danupp/rotor_control/rotor_control_kicad/rotor_control_kicad.pdf

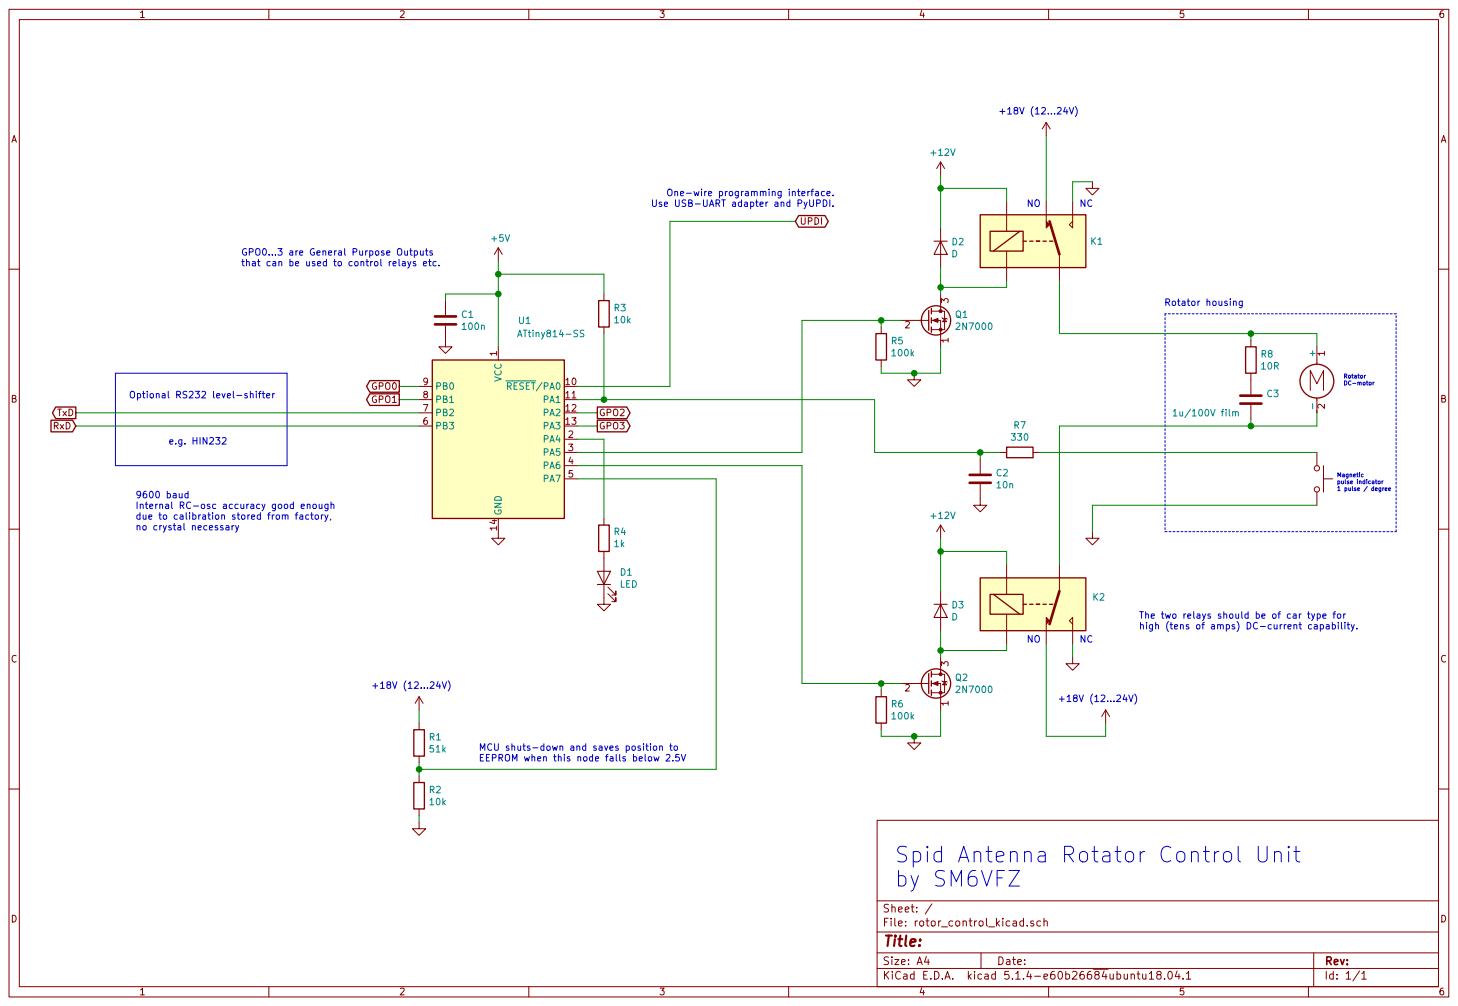
[picture p1: page 1]

One-wire programming interface.

GPO0...3 are General Purpose Outputs
that can be used to control relays etc.

Magnetic pulse indicator 1 pulse / degree Spid Antenna Rotator Control Unit

9600 baud
Internal RC-osc accuracy good enough
due to calibration stored from factory,
no crystal necessary

The two relays should be of car type for
high (tens of amps) DC-current capability.

MCU shuts-down and saves position to EEPROM when this node falls below 2.5V
