danupp/rotor_control/main.c

/* Rotor control for Spid rotors by SM6VFZ

Commands:
r x     --- Rotate to direction/position x degrees
r+ x    --- Rotate clock-wise for x degrees
r- x    --- Rotate counter-clock-wise for x degrees
d       --- Print current position
s       --- Stop ongoing rotation
cal x   --- Set current position to x degrees (without rotating) 
g on y  --- Turn on output y in {0,1,2,3}
g off y --- Turn off output y
temp    --- Measure and print current temperature
 
*/

#include <avr/io.h>
#include <avr/interrupt.h>
#include <avr/pgmspace.h>
#include <avr/sleep.h>
#include <avr/eeprom.h>
#define F_CPU 3333333
#include <util/delay.h>
#include <stdio.h>
#include <stdlib.h>
#include <string.h>

#define LED_pin PIN4_bm // PA4
#define TXD_pin PIN2_bm // PB2
#define RXD_pin PIN3_bm // PB3
#define COMP_pin PIN7_bm // PA7
#define PULSE_pin PIN1_bm // PA1
#define RELA_pin PIN5_bm // PA5
#define RELB_pin PIN6_bm // PA6
#define GPO0_pin PIN0_bm //PB0
#define GPO1_pin PIN1_bm //PB1
#define GPO2_pin PIN2_bm //PA2
#define GPO3_pin PIN3_bm //PA3

#define CW 0x01
#define CCW 0x02
#define MAX_POS 450
#define MIN_POS -90

#define POSITION_EEADDR 0

volatile uint8_t step_flag;
volatile uint8_t process_usart_flag;
volatile uint8_t timeout_flag;
volatile uint8_t rot_flag;
volatile uint8_t poweroff_flag;
volatile uint8_t rx_ptr;
volatile uint8_t timeout;
volatile char rx_buff[30];

uint8_t gpo_on(uint8_t gpo_num) {
  if (gpo_num == 0)
    PORTB.OUT |= GPO0_pin;
  else if (gpo_num == 1)
    PORTB.OUT |= GPO1_pin;
  else if (gpo_num == 2)
    PORTA.OUT |= GPO2_pin;
  else if (gpo_num == 3)
    PORTA.OUT |= GPO3_pin;
  else
    return 1;
  return 0;
}

uint8_t gpo_off(uint8_t gpo_num) {
  if (gpo_num == 0)
    PORTB.OUT &= ~GPO0_pin;
  else if (gpo_num == 1)
    PORTB.OUT &= ~GPO1_pin;
  else if (gpo_num == 2)
    PORTA.OUT &= ~GPO2_pin;
  else if (gpo_num == 3)
    PORTA.OUT &= ~GPO3_pin;
  else
    return 1;
  return 0;
}

void RotStop() {
  rot_flag = 0x00;
  PORTA.OUT &= ~RELA_pin;
  PORTA.OUT &= ~RELB_pin;
  PORTA.OUT &= ~LED_pin;
}

void RotStart(uint8_t dir) {
  rot_flag = 0x01;
  timeout = 0;
  if (dir == CW) {
    PORTA.OUT |= RELA_pin;
    PORTA.OUT &= ~RELB_pin;
  }
  else if (dir == CCW) {
    PORTA.OUT |= RELB_pin;
    PORTA.OUT &= ~RELA_pin;
  }    
  PORTA.OUT |= LED_pin;
}


void USART_Transmit_String(char *buffer) {
  uint8_t n = 0;
  while(buffer[n]) {
    while (!(USART0.STATUS & USART_DREIF_bm));
    USART0.TXDATAL = buffer[n];
    n++;
  }
}

uint16_t measure_temperature() {
  int8_t sigrow_offset = SIGROW.TEMPSENSE1;
  uint8_t sigrow_gain = SIGROW.TEMPSENSE0;
  uint32_t temp;
  //ADC0.MUXPOS = 0x1e; // tempsense
  //_delay_ms(1);
  ADC0.COMMAND = 0x01;
  while (ADC0.COMMAND);
  // Now convert as per datasheet
  temp = ADC0.RES - sigrow_offset;
  temp *= sigrow_gain;
  temp += 0x80;
  temp >>= 8;
  return temp;
}

ISR(AC0_AC_vect) {

  RotStop(); // just in case
  AC0.STATUS |= 0x01; // Clear int flag
  if (!(AC0.STATUS & 0b00010000)) 
    poweroff_flag = 0x01;
    
}

ISR(BOD_VLM_vect) {

  RotStop(); // just in case
  poweroff_flag = 0x02;
}


ISR(RTC_PIT_vect) { // 2 Hz
  RTC.PITINTFLAGS = 0x01; // clear flag
  //PORTA.OUTTGL = LED_pin;
  if (rot_flag) {
    timeout ++;
    if(timeout>4) {
      RotStop();
      timeout_flag = 0x01;
    }
  }

}


ISR(PORTA_PORT_vect) {
  
  if(PORTA.INTFLAGS & PULSE_pin) {
    PORTA.INTFLAGS |= PULSE_pin; // Clear flag
    step_flag = 0x01;
  }  
}

/*
ISR(TCA0_OVF_vect) { // 192.0 kHz @ 19.2 MHz 
  TCA0.SINGLE.INTFLAGS = 0x01; // clear flag
}
*/

ISR (USART0_RXC_vect) {

  unsigned char udr_rx;

  /* Get and return received data from buffer */
  if (USART0.RXDATAH & USART_FERR_bm)
    udr_rx = USART0.RXDATAL;
  else {
    udr_rx = USART0.RXDATAL;
    USART0.TXDATAL = udr_rx;
    
    if (udr_rx=='\n') {
      process_usart_flag = 1;
    }
    else if (rx_ptr < 28) {
      rx_buff[rx_ptr]=udr_rx;
      rx_ptr++;
    }
  }
}

void main () {
  char buffer[50];
  int16_t position, target_position, ang;
  uint8_t direction;

  static const char string_start[] PROGMEM = "\n*******\nRotor control by SM6VFZ\n\n";
  static const char string_timeout[] PROGMEM = "\nTimeout, No feedback!\n";
  static const char string_temperature[] PROGMEM = "Temperature: ";
  static const char string_step_too_small[] PROGMEM = "Step too small.";
  static const char string_pos[] PROGMEM = "Position: ";
  static const char string_forcing[] PROGMEM = "-> Forcing pos to ";
  static const char string_degrees[] PROGMEM = " deg";
  static const char string_stopping[] PROGMEM = "Stopping at ";
  static const char string_starting[] PROGMEM = "Starting rot..";
  // static const char string_save[] PROGMEM = "Saving position to EEPROM.";
  // static const char string_load[] PROGMEM = "(Re)loading position from EEPROM.";
  static const char string_gpo_on[] PROGMEM = "Turning on output ";
  static const char string_gpo_off[] PROGMEM = "Turning off output ";
  static const char string_quit_ac[] PROGMEM = "\n*AC*";
  static const char string_quit_vlm[] PROGMEM = "\n*VLM*";
  static const char string_quit[] PROGMEM = "\n*** Good night. ***";
  
  PORTA.DIR = LED_pin | RELA_pin | RELB_pin | GPO2_pin | GPO3_pin; // outputs
  PORTB.DIR = TXD_pin | GPO0_pin | GPO1_pin;
  PORTA.PIN7CTRL = 0x04; // digital input disable for AINP0/PA7
  PORTA.PIN1CTRL = 0x01; // int at both edges

  PORTA.OUT = 0x00;
  PORTB.OUT = 0x00;

  _delay_ms(1000); // To wait for voltages to stabilize
  
  BOD.VLMCTRLA = 0x02; // VLM 25% over BOD
  BOD.INTCTRL = 0x01;  // VLM INT when voltage crosses from above
  
  VREF.CTRLA = 0b00010010; // 1.1V for ADC, 2.5V for comparator
  
  ADC0.CTRLC = 0x01; // int ref, ./4 prescaler
  ADC0.CTRLD = 0b10000000; // 128 CLK_ADC INITDLY
  ADC0.SAMPCTRL = 0b00001000; // 32 1/f samplen -> 38.4us
  ADC0.MUXPOS = 0x1e; // tempsense
  ADC0.CTRLA = 0b00000001; // ADC enable at 10 bits resolution

  measure_temperature();  // Seems necessary to get rid of first garbage values

  AC0.MUXCTRLA = 0x02; // VREF to NEGIN
  AC0.INTCTRL = 0x01; // enable interrupt
  AC0.CTRLA = 0b00100001; // int at neg edge, no hyst, enable

  //USART0.BAUD = 1389;  // 9600 baud for 3.33 MHz and normal mode

  /* Baud rate compensated with factory stored frequency error */
  int8_t sigrow_val = SIGROW.OSC20ERR5V;
  int32_t baud_reg_val = (int32_t)1389;

  baud_reg_val *= (1024 + sigrow_val);
  baud_reg_val /= 1024;
  USART0.BAUD = (int16_t) baud_reg_val;

  USART0.CTRLA = 0b10000000; // RXCIE
  USART0.CTRLB = 0b11000000; // RX+TX enable
  rx_ptr=0;
  
  while(RTC.STATUS);
  RTC.CLKSEL = 0x00; // Use 32 kHz from OSC32K
  while(RTC.PITSTATUS);
  RTC.PITINTCTRL = 0x01; // enable interrupt
  while(RTC.PITSTATUS);
  RTC.PITCTRLA = 0b01101001; // Enable, interrupt after 16384 cycles => 2Hz

  position = eeprom_read_word(POSITION_EEADDR); // Read out last position
  
  strcpy_P(buffer, string_start);
  USART_Transmit_String(buffer);
  sprintf(buffer,"\nStart at %d deg.\n> ", position);
  USART_Transmit_String(buffer);

  PORTA.OUT |= LED_pin;
  _delay_ms(200);
  PORTA.OUT &= ~LED_pin;
  _delay_ms(200);
  PORTA.OUT |= LED_pin;
  _delay_ms(200);
  PORTA.OUT &= ~LED_pin;
  _delay_ms(200);
  PORTA.OUT |= LED_pin;
  _delay_ms(200);
  PORTA.OUT &= ~LED_pin;

  rot_flag = 0x00;
  step_flag = 0x00;
  process_usart_flag = 0x00;
  timeout_flag = 0x00;
  poweroff_flag = 0x00;

  AC0.STATUS |= 0x01; // Clear int flag
  
  sei();
   
  while(1) {
    if(poweroff_flag) {
      cli();
      eeprom_write_word(POSITION_EEADDR,position);
      if (poweroff_flag == 0x01) { // AC 
	strcpy_P(buffer, string_quit_ac);
      }
      else if (poweroff_flag == 0x02) { // VLM
	strcpy_P(buffer, string_quit_vlm);
	BOD.INTFLAGS = 0x00;
      }
      USART_Transmit_String(buffer);
      strcpy_P(buffer, string_quit);
      USART_Transmit_String(buffer);
      _delay_ms(10000);
      poweroff_flag = 0x00;
      sei(); // if we wake up again
    }
    else if(step_flag) {
      cli();
      step_flag = 0x00;
      _delay_ms(5);
      if ((direction == CW) && (PORTA.IN & PULSE_pin)) { // Low-to-high
	timeout = 0;
	position++;
	USART_Transmit_String("+");
	if(rot_flag && ((position > MAX_POS) || (position >= target_position))) {
	  RotStop();
	  USART_Transmit_String("\n> ");
	}
      }
      else if ((direction == CCW) && !(PORTA.IN & PULSE_pin)) { //High-to-low
	timeout = 0;
	position--;
	USART_Transmit_String("-");
	timeout = 0;
	if (rot_flag && ((position < MIN_POS) || (position <= target_position))) {
	  RotStop();
	  USART_Transmit_String("\n> ");
	}
      }
      PORTA.INTFLAGS |= PULSE_pin; // Clear flag, if set again
      sei();
    }
    else if (process_usart_flag) {
      rx_ptr=0;
      
      if (strncmp((const char *)rx_buff,"?",1)==0) {
         strcpy_P(buffer, string_start);
	 USART_Transmit_String(buffer);
      }
      else if (strncmp((const char *)rx_buff,"temp",4)==0) {
         strcpy_P(buffer, string_temperature);
	 USART_Transmit_String(buffer);
	 sprintf(buffer,"%d C",measure_temperature()-273);
	 USART_Transmit_String(buffer);
      }
      else if (strncmp((const char *)rx_buff,"r+ ",3)==0) {
         if(sscanf((const char *)rx_buff+3,"%d",&ang)) {
            if (ang > 3) {
	      target_position=position+ang;
	      direction = CW;
	      RotStart(direction);
	      strcpy_P(buffer, string_starting);
	      USART_Transmit_String(buffer);
	    }
	    else {
	       strcpy_P(buffer, string_step_too_small);
	       USART_Transmit_String(buffer);
            }
	 }
      }
      else if (strncmp((const char *)rx_buff,"r- ",3)==0) {
         if(sscanf((const char *)rx_buff+3,"%d",&ang)) {
            if (ang > 3) {
	      target_position=position-ang;
	      direction=CCW;
	      RotStart(direction);
	      strcpy_P(buffer, string_starting);
	      USART_Transmit_String(buffer);
	    }
	    else {
	       strcpy_P(buffer, string_step_too_small);
	       USART_Transmit_String(buffer);
            }
	 }
      }
      else if (strncmp((const char *)rx_buff,"r ",2)==0) {
	if(sscanf((const char *)rx_buff+2,"%d",&ang)) {
	  if ((ang > (position - 3)) && (ang < (position + 3))) {
 	    strcpy_P(buffer, string_step_too_small);
	    USART_Transmit_String(buffer);
	  }
	  else {
	    if (ang > position) {
	      target_position = ang;
	      direction=CW;
	      RotStart(direction);
	    }
	    else if (ang < position) {
	      target_position = ang;
	      direction=CCW;
	      RotStart(direction);
	    }
	    strcpy_P(buffer, string_starting);
	    USART_Transmit_String(buffer);
	  }
	}
      }
      else if (strncmp((const char *)rx_buff,"cal ",4)==0) {
	if(sscanf((const char *)rx_buff+4,"%d",&ang)) {
	  position = ang;
	  strcpy_P(buffer, string_forcing);
	  USART_Transmit_String(buffer);
	  sprintf(buffer,"%d",position);
	  USART_Transmit_String(buffer);
	  strcpy_P(buffer, string_degrees);
	  USART_Transmit_String(buffer);
	}
      }
      /* Load and save functions only for debug/development */
      /*   
      else if (strncmp((const char *)rx_buff,"load",4)==0) {
	RotStop(); // just in case
	strcpy_P(buffer, string_load);
	USART_Transmit_String(buffer);
	position=eeprom_read_word(POSITION_EEADDR);
      }
      else if (strncmp((const char *)rx_buff,"save",4)==0) {
	RotStop(); // just in case
	strcpy_P(buffer, string_save);
	USART_Transmit_String(buffer);
	eeprom_write_word(POSITION_EEADDR,position);
      }
      */
      else if (strncmp((const char *)rx_buff,"d",1)==0) {
	strcpy_P(buffer, string_pos);
	USART_Transmit_String(buffer);
	sprintf(buffer,"%d",position);
	USART_Transmit_String(buffer);
	strcpy_P(buffer, string_degrees);
	USART_Transmit_String(buffer);
      }
      else if (strncmp((const char *)rx_buff,"s",1)==0) {
        RotStop();
	strcpy_P(buffer, string_stopping);
	USART_Transmit_String(buffer);
	sprintf(buffer,"%d",position);
	USART_Transmit_String(buffer);
	strcpy_P(buffer, string_degrees);
	USART_Transmit_String(buffer);
      }
      else if (strncmp((const char *)rx_buff,"g ",2)==0) {
	uint8_t gpo_num;
	if (strncmp((const char *)rx_buff+2,"on",2)==0) {
	  if(sscanf((const char *)rx_buff+5,"%d",&gpo_num)) {
	    if(!gpo_on(gpo_num)) {
	      strcpy_P(buffer, string_gpo_on);
	      USART_Transmit_String(buffer);
	      sprintf(buffer,"%d.",gpo_num);
	      USART_Transmit_String(buffer);
	    }
	    else {
	      USART_Transmit_String("?");
	    }
	  }
	  else {
	    USART_Transmit_String("?");
	  }
	}
	else if (strncmp((const char *)rx_buff+2,"off",3)==0) {
	  if(sscanf((const char *)rx_buff+6,"%d",&gpo_num)) {
	    if(!gpo_off(gpo_num)) {
	      strcpy_P(buffer, string_gpo_off);
	      USART_Transmit_String(buffer);
	      sprintf(buffer,"%d.",gpo_num);
	      USART_Transmit_String(buffer);
	    }
	    else {
	      USART_Transmit_String("?");
	    }
	  }
	  else {
	    USART_Transmit_String("?");
	  }
	}
      }
      else {
	USART_Transmit_String("?");
      }
      USART_Transmit_String("\n> ");
      memset((char *)rx_buff,'\0',30); 
      process_usart_flag = 0;
    }
    if (timeout_flag) {
      timeout_flag = 0x00;
      strcpy_P(buffer, string_timeout);
      USART_Transmit_String(buffer);
      USART_Transmit_String("\n> ");      
    }
    sleep_mode();
  }
  
}
